mayrs/knock-knock-arduino-doorbell-telegram-notifier/Screenshots/adjust_gain.png

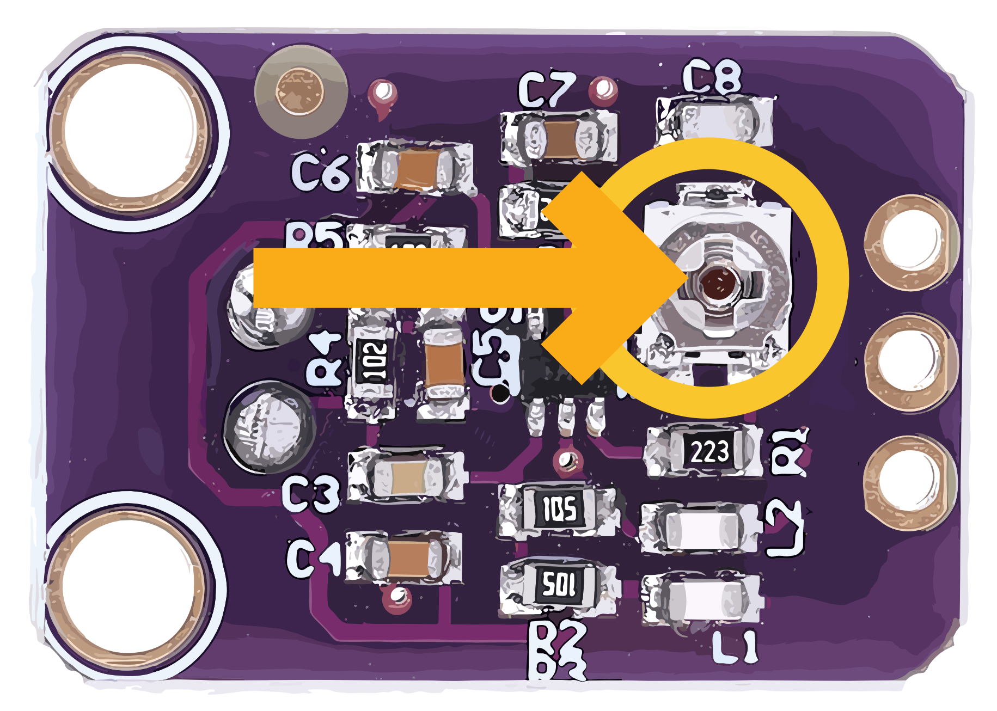
Screenshots/adjust_gain.png
