mayrs/knock-knock-arduino-doorbell-telegram-notifier/Screenshots/attach_knock_knock.gif

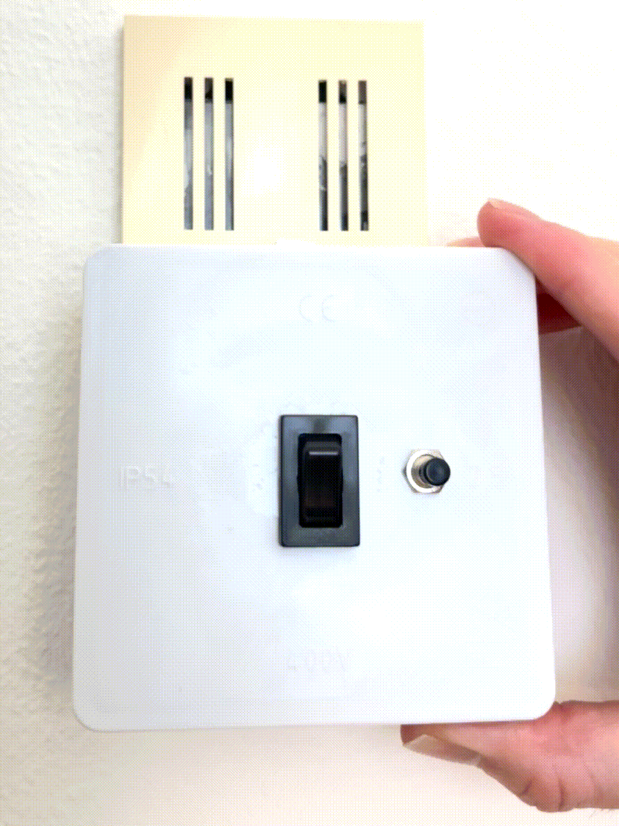
Screenshots/attach_knock_knock.gif
