mayrs/knock-knock-arduino-doorbell-telegram-notifier/Screenshots/botfather.png

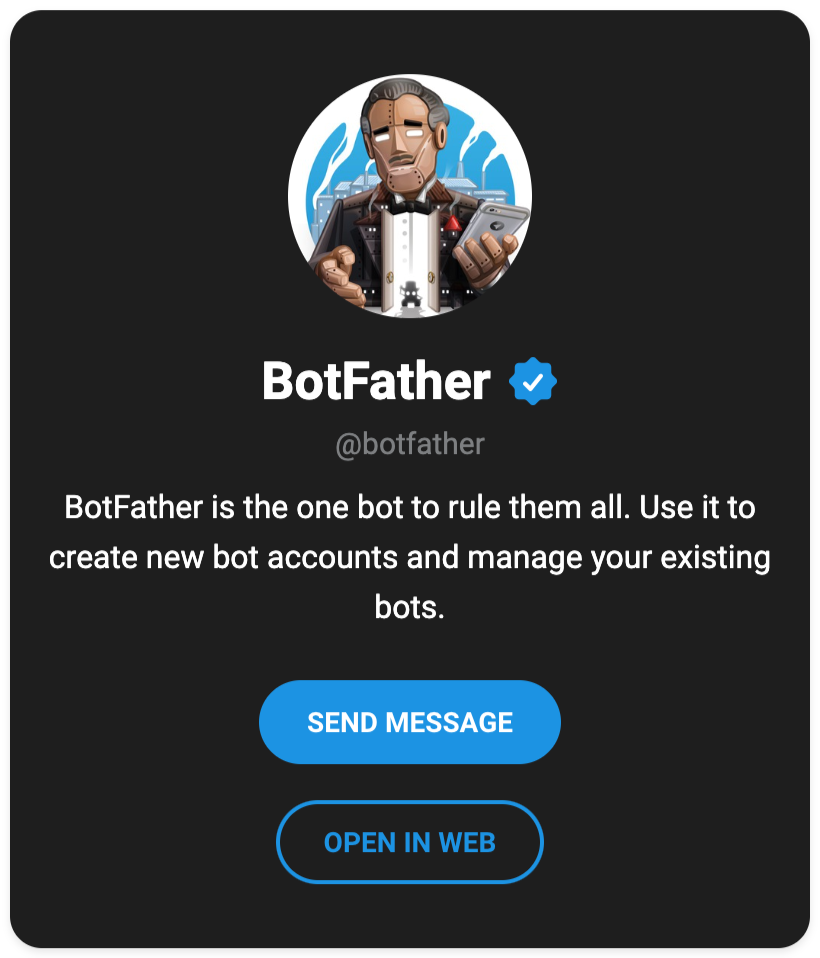
Screenshots/botfather.png
