mayrs/knock-knock-arduino-doorbell-telegram-notifier/Screenshots/doorbell.gif

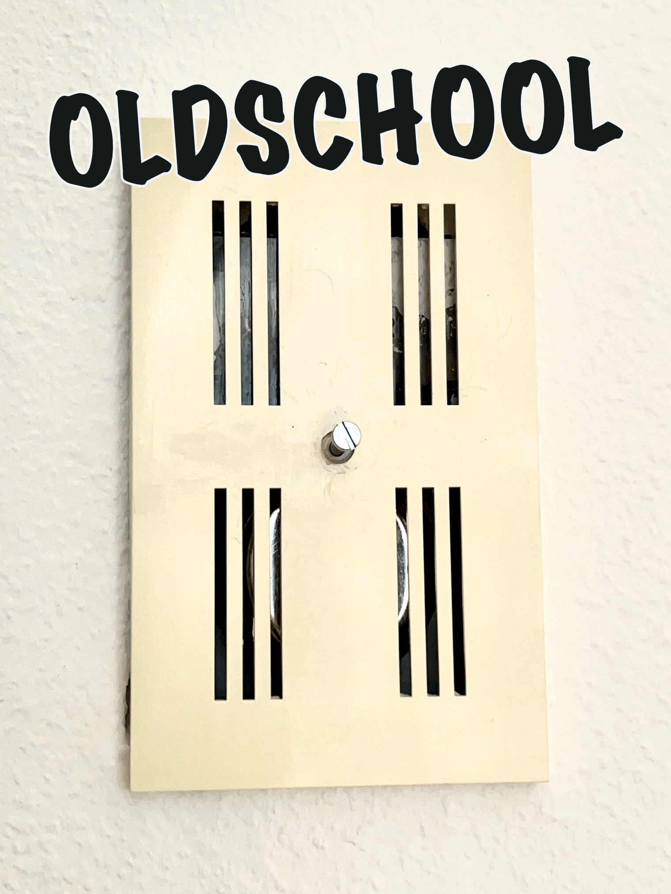
Screenshots/doorbell.gif
