mayrs/knock-knock-arduino-doorbell-telegram-notifier/Screenshots/favor_share_imadeit.jpg

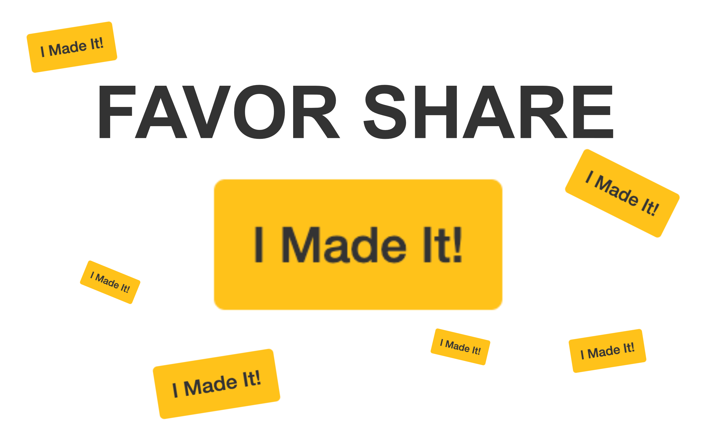
Screenshots/favor_share_imadeit.jpg
