mayrs/knock-knock-arduino-doorbell-telegram-notifier/Screenshots/flashing.png

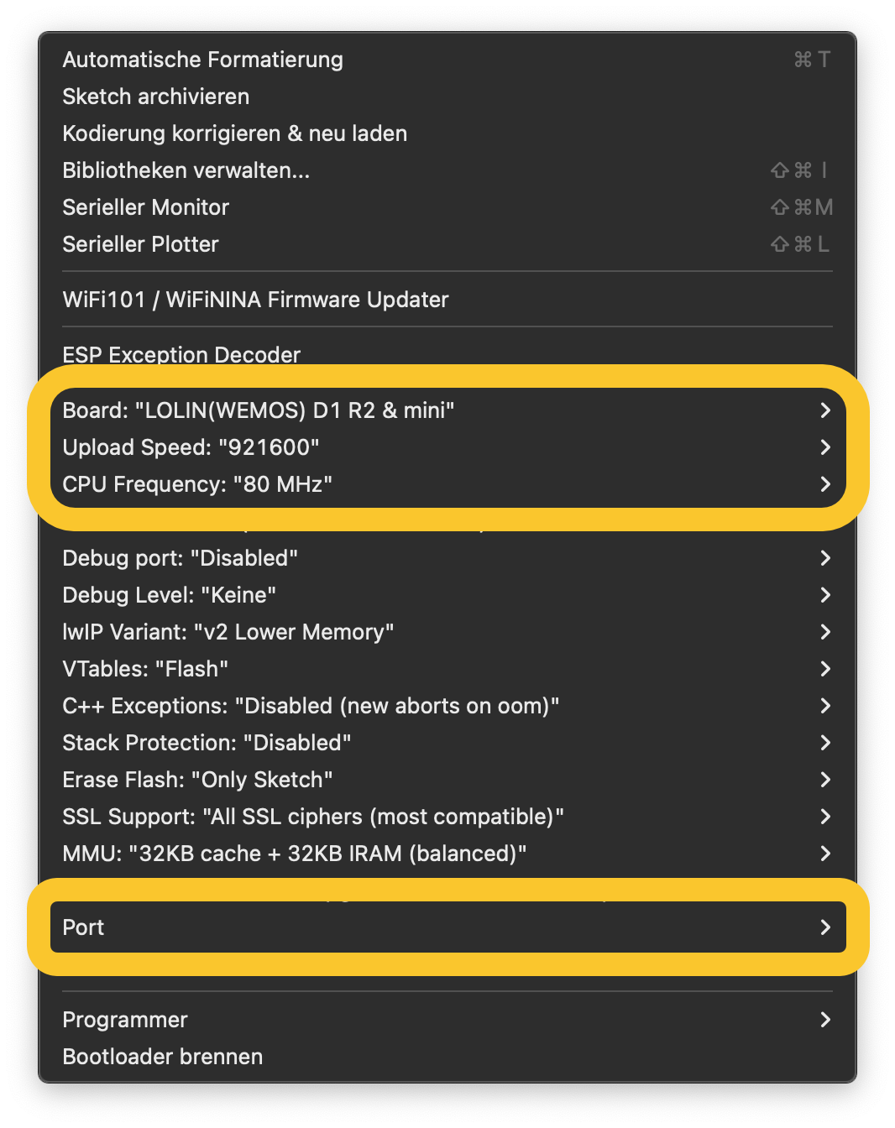
Screenshots/flashing.png
