mayrs/knock-knock-arduino-doorbell-telegram-notifier/Screenshots/knock_knock_1.jpg

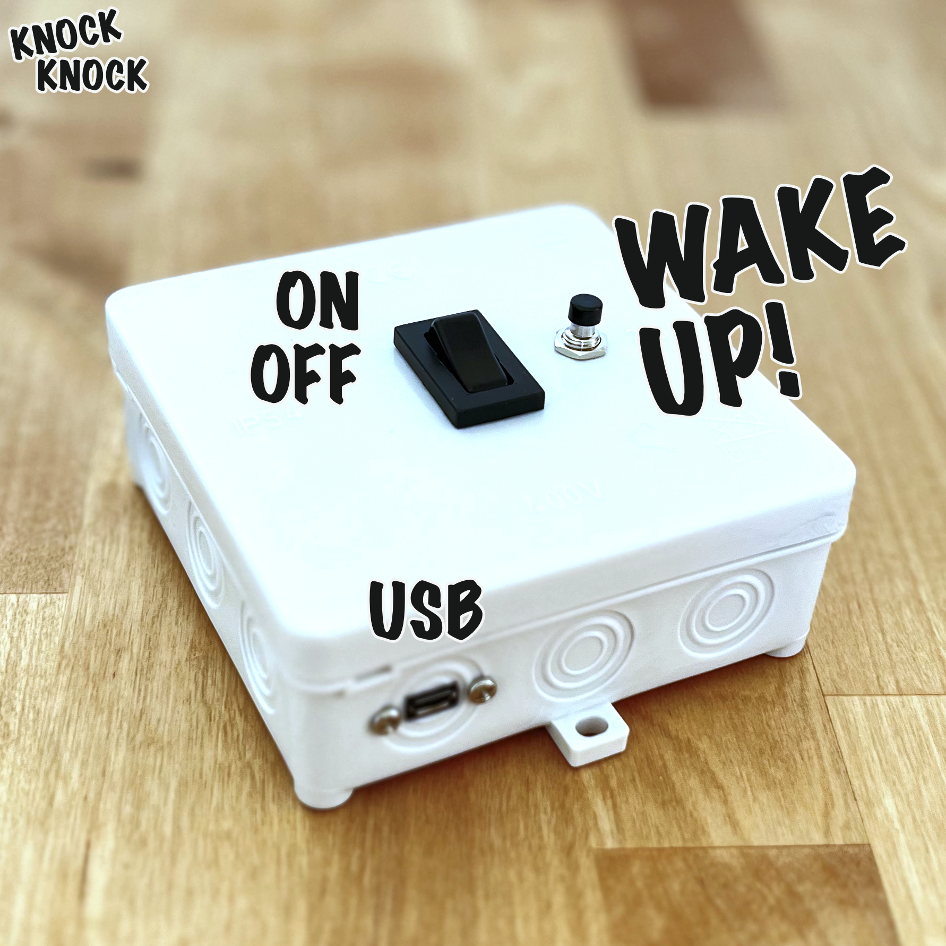
Screenshots/knock_knock_1.jpg
