mayrs/knock-knock-arduino-doorbell-telegram-notifier/Screenshots/knock_knock_2.jpg

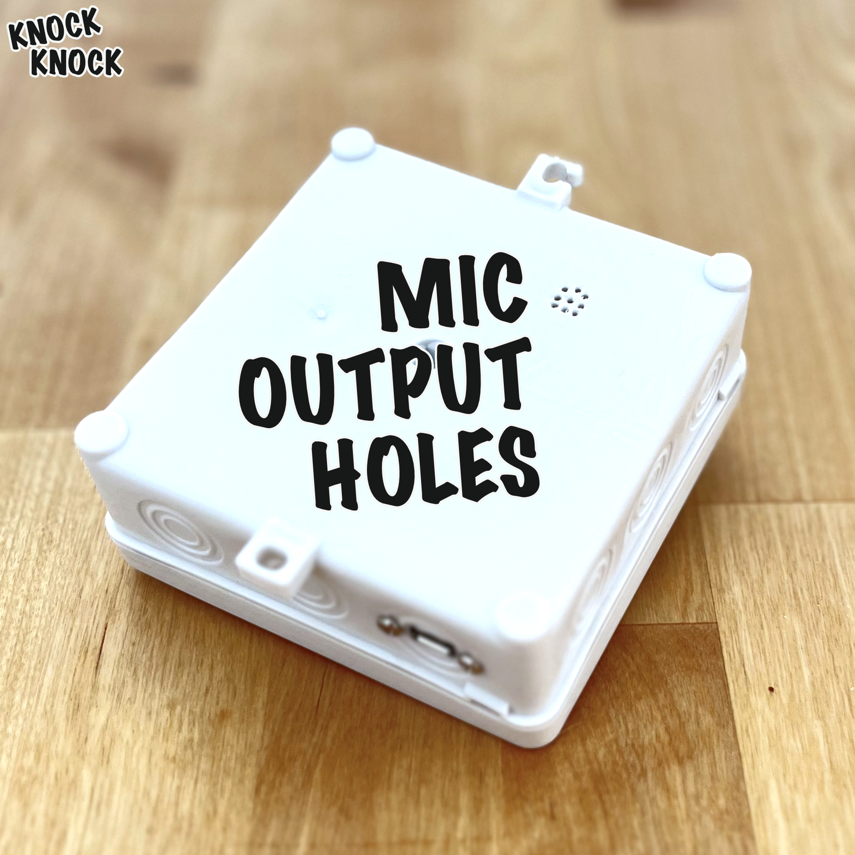
Screenshots/knock_knock_2.jpg
