mayrs/knock-knock-arduino-doorbell-telegram-notifier/Screenshots/knock_knock_3.jpg

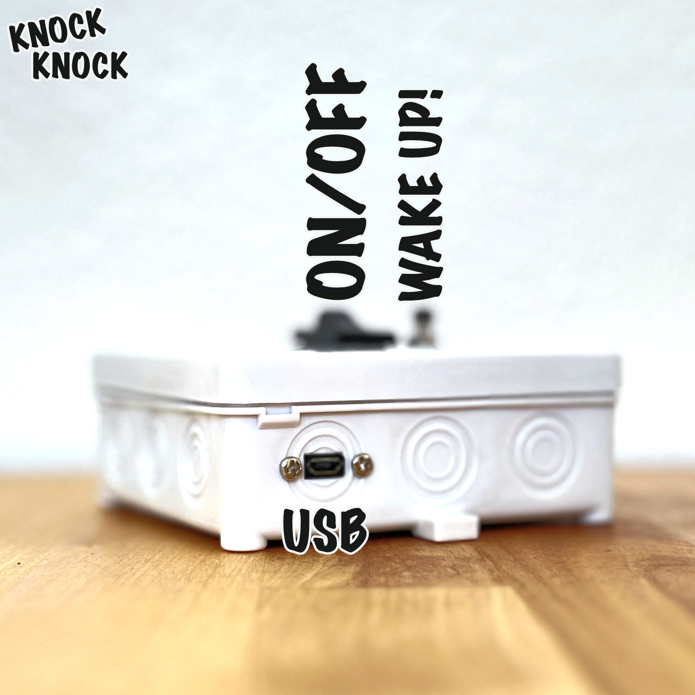
Screenshots/knock_knock_3.jpg
