mayrs/knock-knock-arduino-doorbell-telegram-notifier/Screenshots/knock_knock_4.jpg

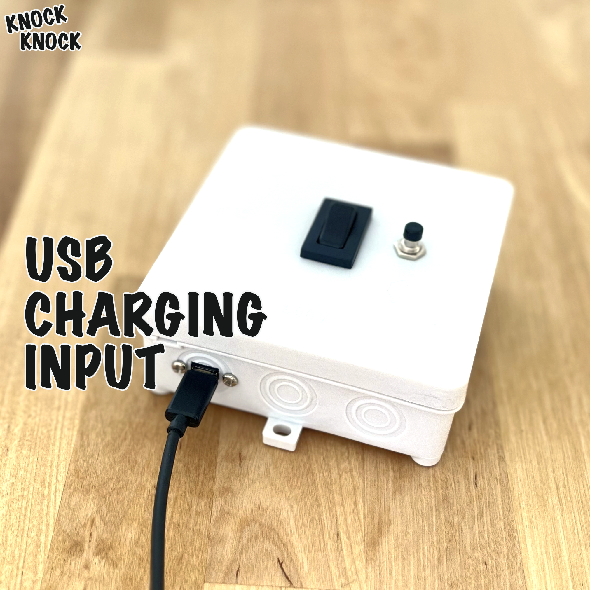
Screenshots/knock_knock_4.jpg
