mayrs/knock-knock-arduino-doorbell-telegram-notifier/Screenshots/knock_knock_5.jpg

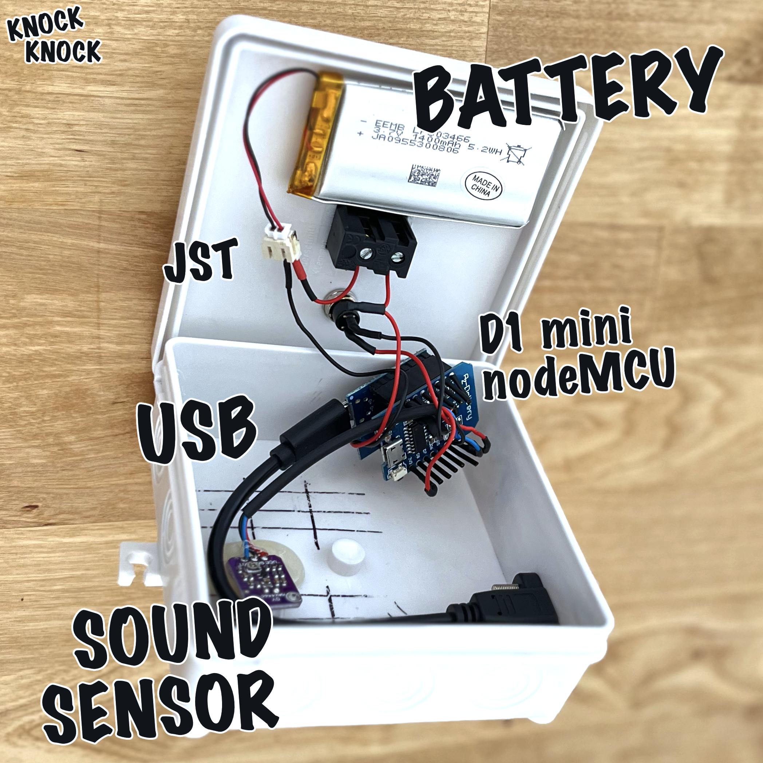
Screenshots/knock_knock_5.jpg
