mayrs/knock-knock-arduino-doorbell-telegram-notifier/Screenshots/knock_knock_github_social_preview.jpg

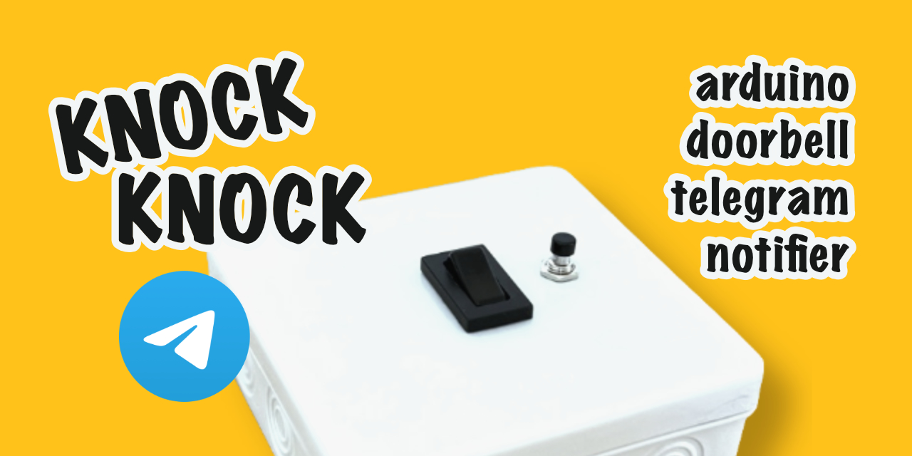
Screenshots/knock_knock_github_social_preview.jpg
