mayrs/knock-knock-arduino-doorbell-telegram-notifier/Screenshots/more_on_github.png

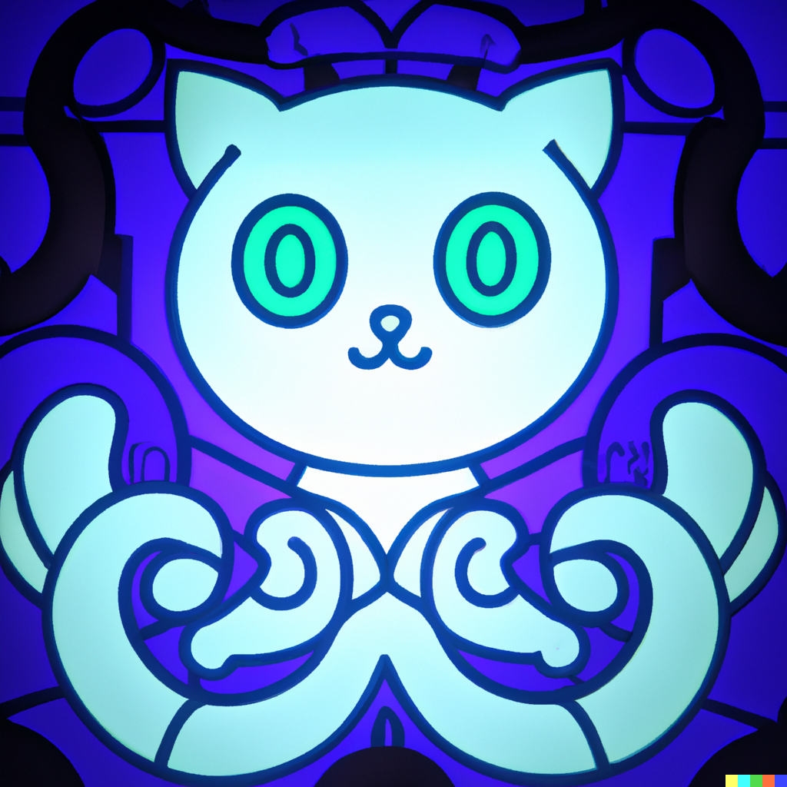
Screenshots/more_on_github.png
