mayrs/knock-knock-arduino-doorbell-telegram-notifier/Screenshots/passwords_h.png

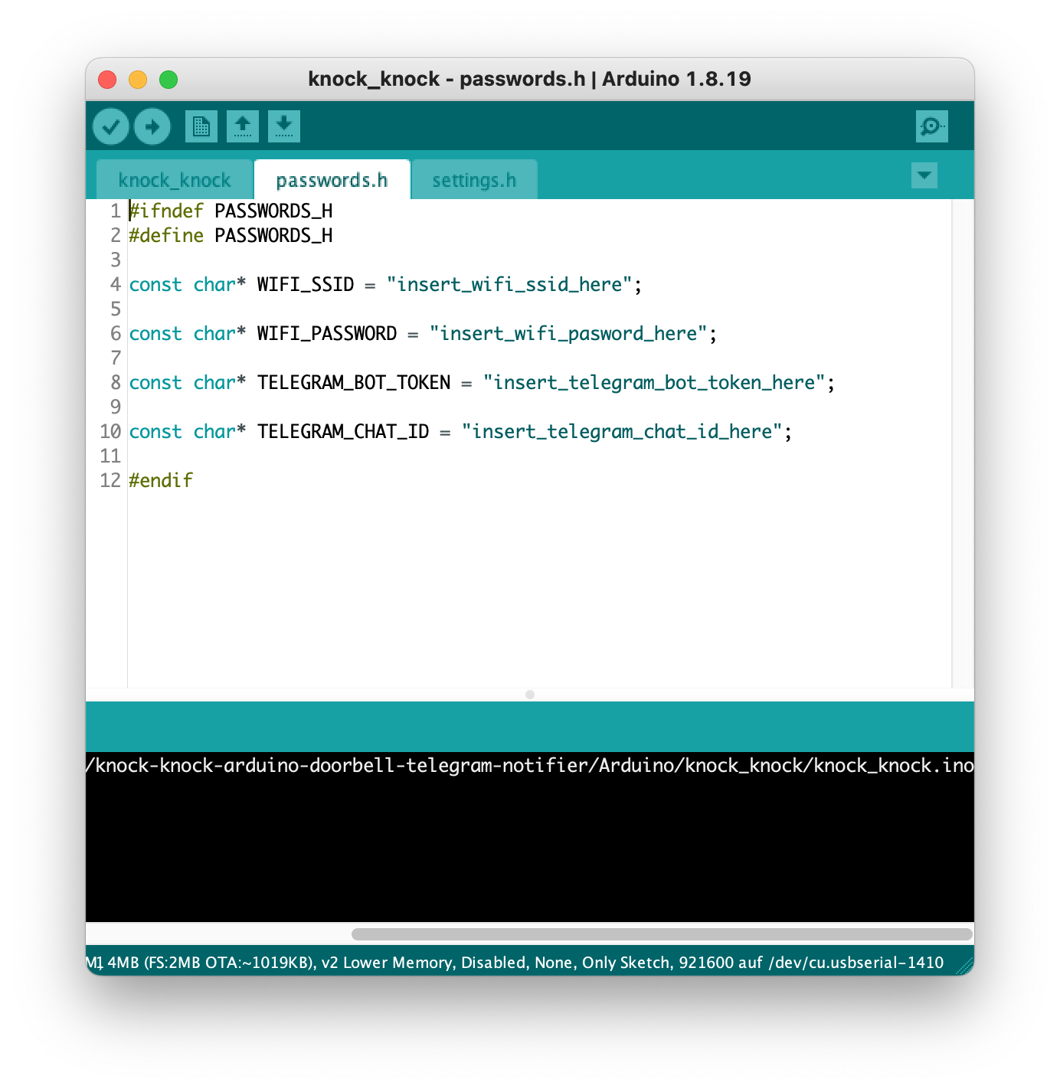
Screenshots/passwords_h.png
