mayrs/knock-knock-arduino-doorbell-telegram-notifier/Screenshots/settings_h.png

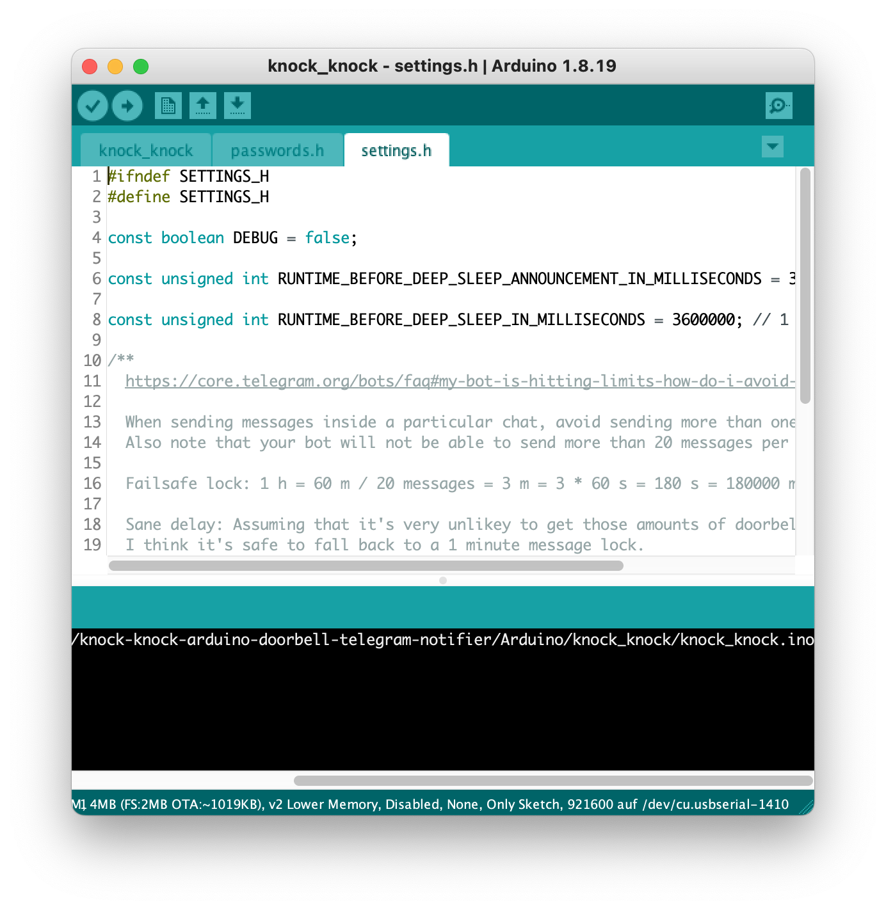
Screenshots/settings_h.png
