mayrs/knock-knock-arduino-doorbell-telegram-notifier/Screenshots/turn_knock_knock_on.gif

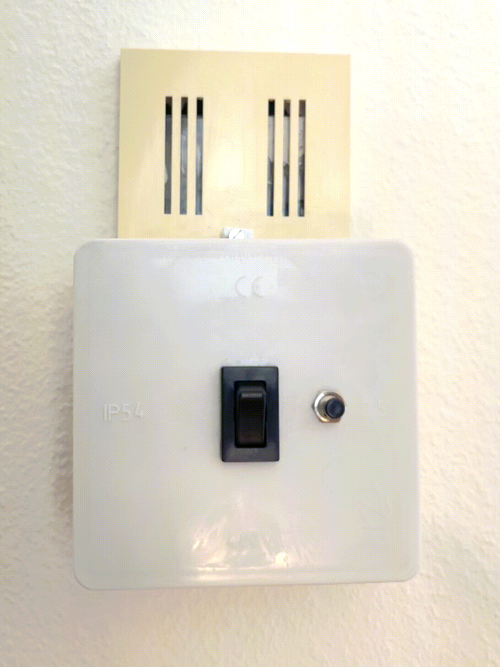
Screenshots/turn_knock_knock_on.gif
