mayrs/knock-knock-arduino-doorbell-telegram-notifier/Screenshots/wake_up_knock_knock.gif

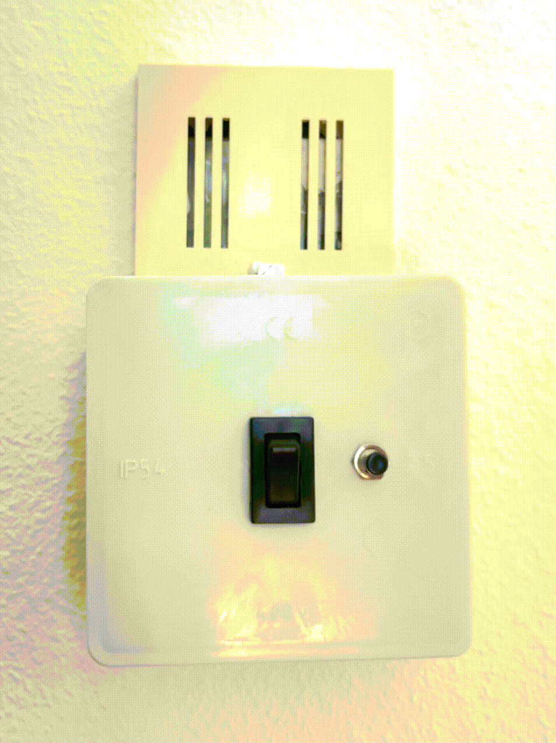
Screenshots/wake_up_knock_knock.gif
