mayrs/knock-knock-arduino-doorbell-telegram-notifier/Screenshots/parts.png

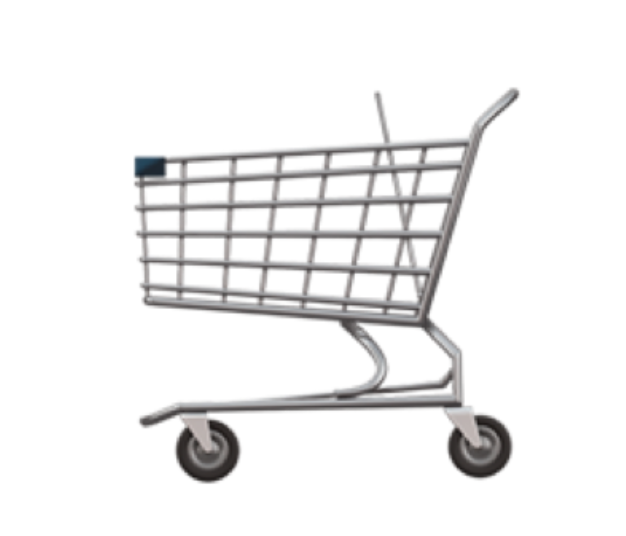
Screenshots/parts.png
