mayrs/knock-knock-arduino-doorbell-telegram-notifier/Screenshots/wiring_diagram.jpg

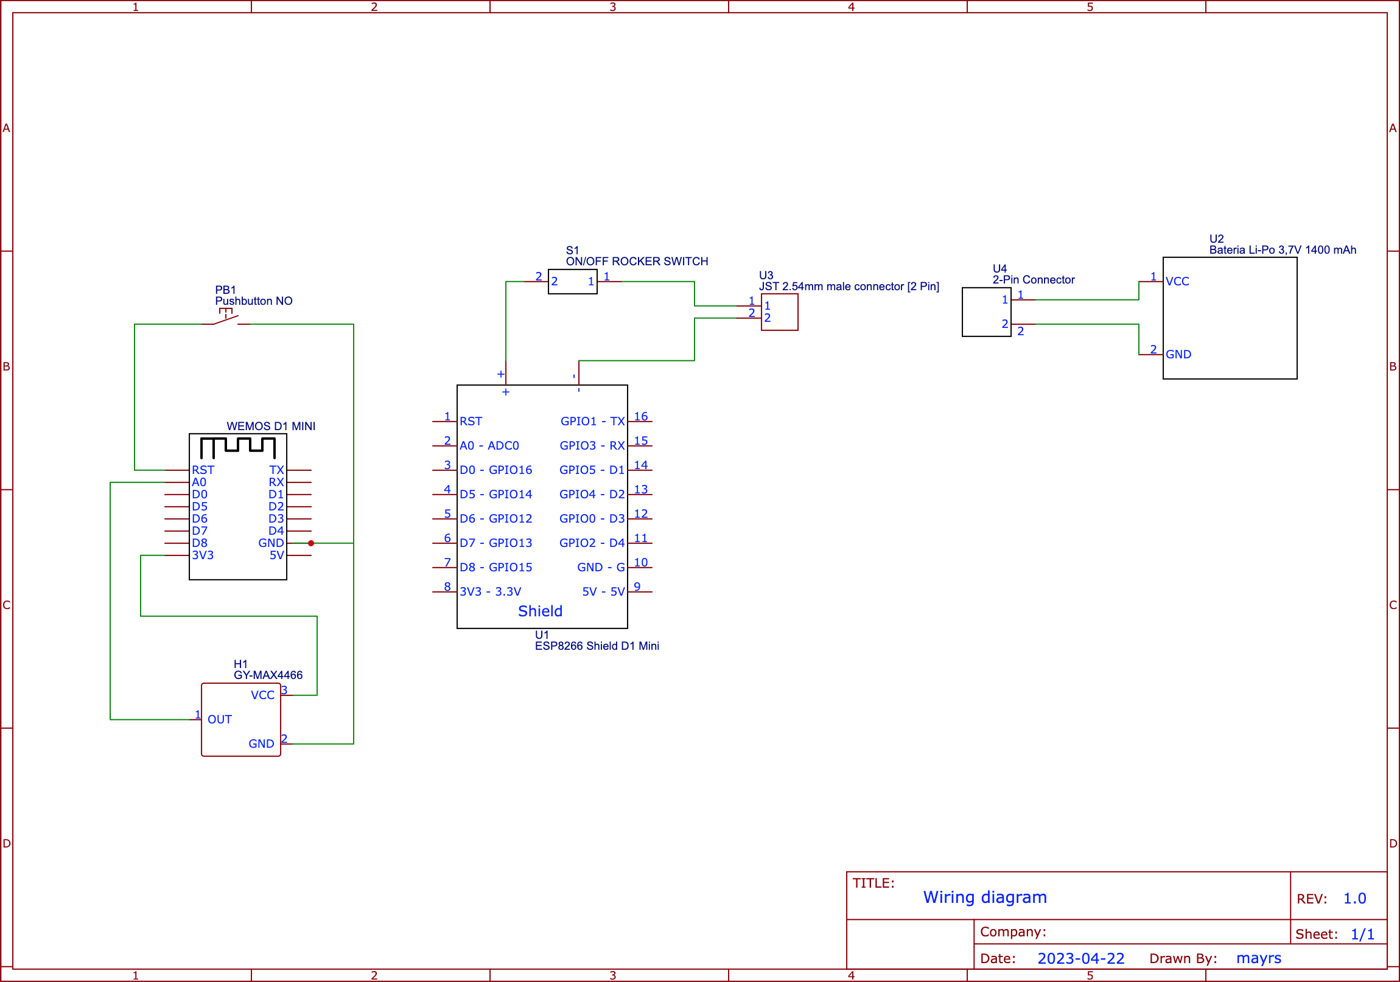
Screenshots/wiring_diagram.jpg
