mayrs/knock-knock-arduino-doorbell-telegram-notifier/Arduino/knock_knock/passwords_template.h

#ifndef PASSWORDS_H
#define PASSWORDS_H

const char* WIFI_SSID = "insert_wifi_ssid_here";

const char* WIFI_PASSWORD = "insert_wifi_pasword_here";

const char* TELEGRAM_BOT_TOKEN = "insert_telegram_bot_token_here";

const char* TELEGRAM_CHAT_ID = "insert_telegram_chat_id_here";

#endif
